bastl-instruments/senseMini/useCases/IMG_7360.JPG

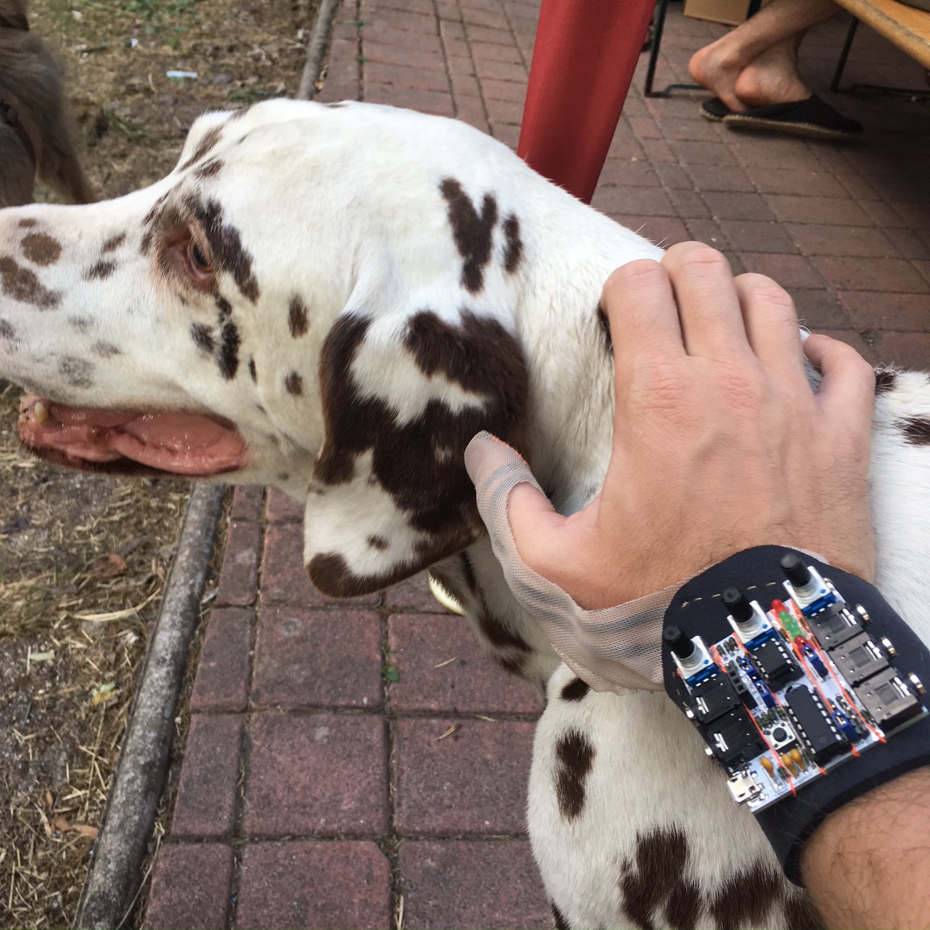
useCases/IMG_7360.JPG
