bastl-instruments/senseMini/useCases/IMG_7311.JPG

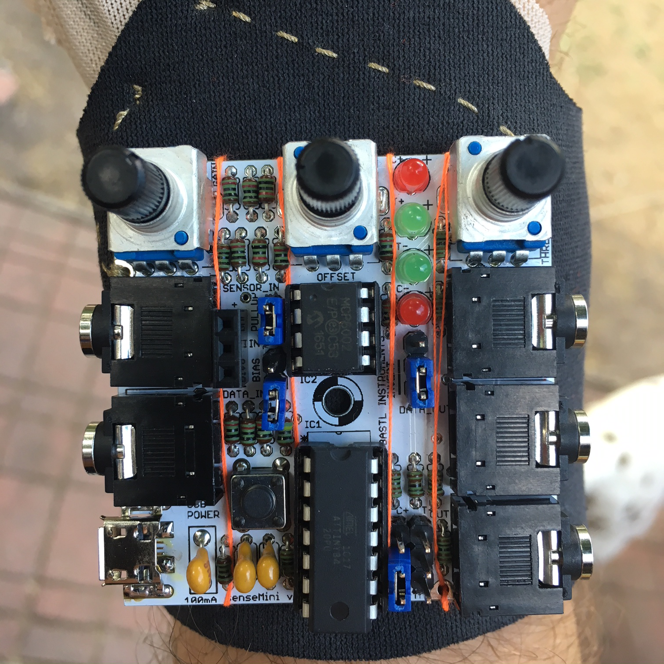
useCases/IMG_7311.JPG
