bastl-instruments/senseMini/manual/senseMini_schematics.png

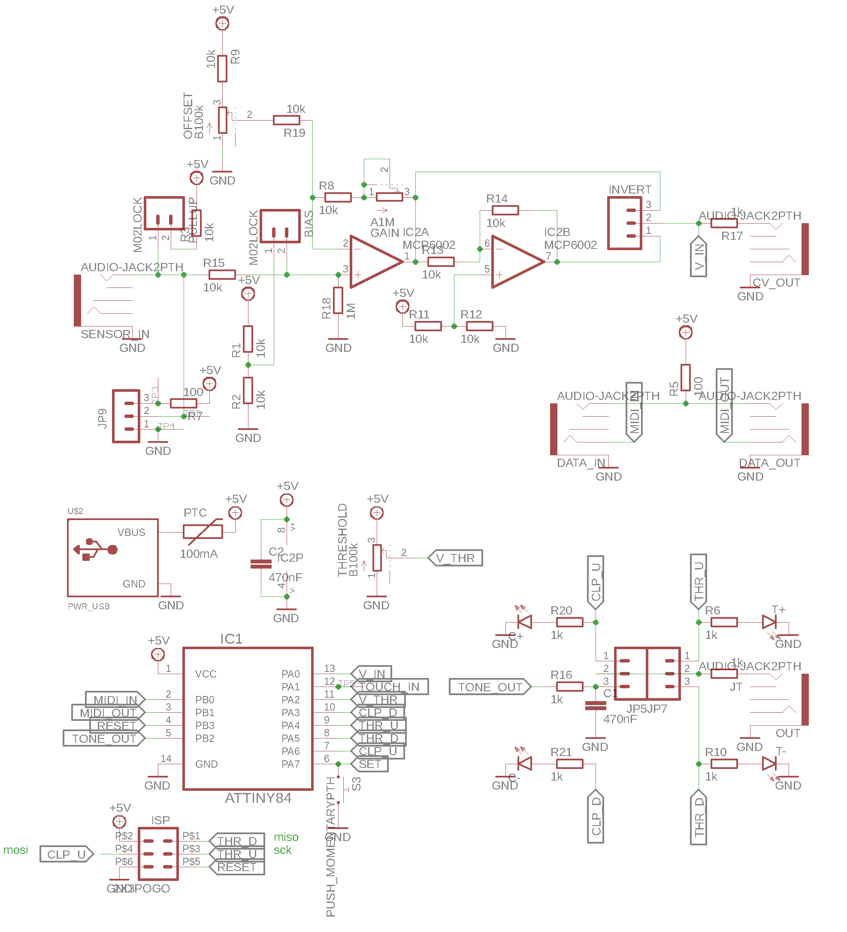
manual/senseMini_schematics.png
