bastl-instruments/senseMini/hw_files/senseMini.dxf

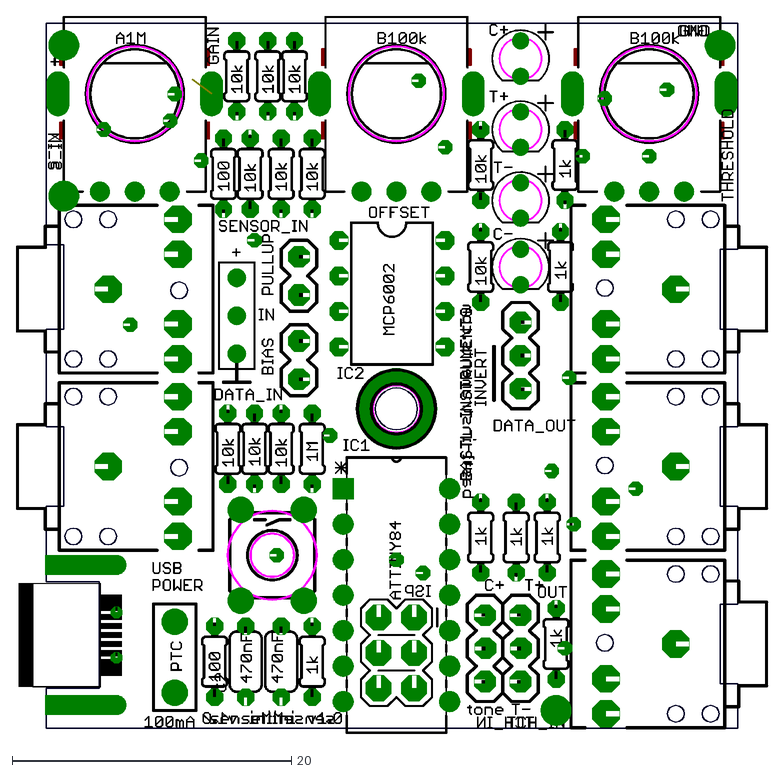
[picture p4: CAD file, 2018-08-09]
hw_files/senseMini.dxf
53.8 x 51.4
