bastl-instruments/senseMini/hw_files/senseMini_future.brd

## EAGLE design hw_files/senseMini_future.brd (2018-08-10)

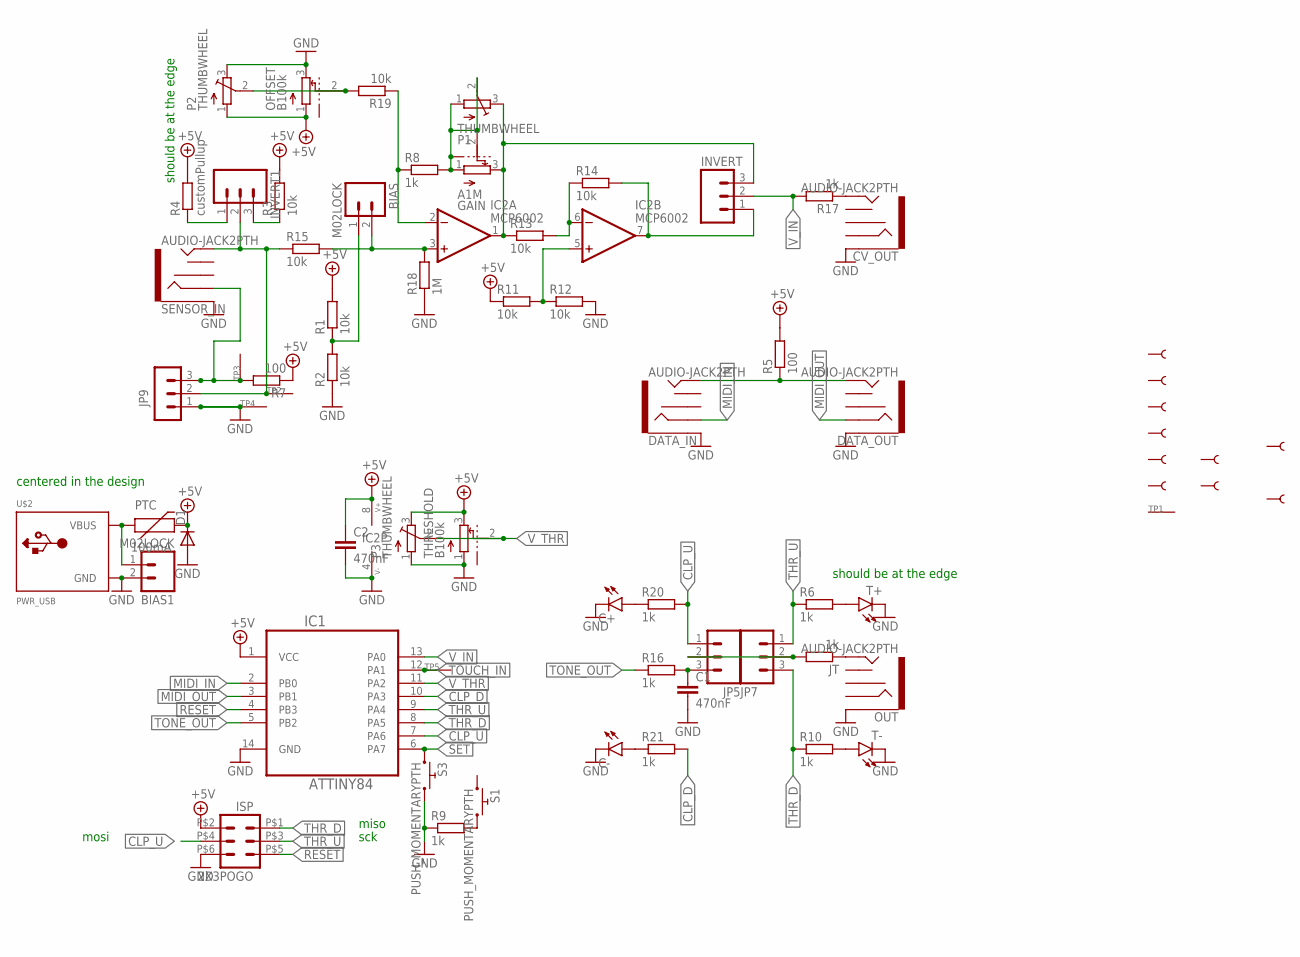
[picture p5: schematic senseMini_future.sch]

Parts:
BIAS, BIAS1: M02LOCK; 1X02_LOCK
C1, C2: 470nF; C_C050-024X044
C+: LED_THT; LEDSMALLHOLES
C-: LED_THT; LEDSMALLHOLES
CV_OUT: AUDIO-JACK2PTH; AUDIO-JACK
D1: DIODE-D-5; D-5
DATA_IN: AUDIO-JACK2PTH; AUDIO-JACK
DATA_OUT: AUDIO-JACK2PTH; AUDIO-JACK
GAIN: A1M; POT_ALPHA
IC1: ATTINY84; DIP254P762X533-14
IC2: MCP6002; DIL08
INVERT, INVERT1: M03LOCK; 1X03_LOCK
ISP: 2X3POGO; 2X3_POGO
JP5, JP7: M03LOCK; 1X03_LOCK
JP9: 1X3_FEMALE; HEADER_1X3_FEMALE
JT: 1k; RCL_0204/5
OFFSET: B100k; POT_ALPHA
OUT: AUDIO-JACK2PTH; AUDIO-JACK
P1, P2, P3: THUMBWHEEL
PTC: 100mA; PTC_THT
R1, R2, R3, R11, R12, R13, R14, R15, R19: 10k; RCL_0204/5
R4: customPullup; RCL_0204/5
R5, R7: 100; RCL_0204/5
R6, R8, R9, R10, R16, R17, R20, R21: 1k; RCL_0204/5
R18: 1M; RCL_0204/5
S1, S3: PUSH_MOMENTARYPTH; TACTILE-PTH
SENSOR_IN: AUDIO-JACK2PTH; AUDIO-JACK
T+: LED_THT; LEDSMALLHOLES
T-: LED_THT; LEDSMALLHOLES
THRESHOLD: B100k; POT_ALPHA
TP1: SEWTAP-2.0IN; SEWINGTAP_2.0
TP2, TP3, TP4, TP5: SEWTAP0.5IN; SEWINGTAP_0.5
U$2: PWR_USB; USBMICRO
U$3, U$4, U$9, U$10, U$11, U$12: SEWTAP2; PETAL-LONG-2
U$5, U$6, U$7, U$8: SEWTAP6; PETAL-SMALL-2SIDE

Connections:
+5V: C2.1, D1.C, IC1.1 (VCC), IC2.8 (V+), ISP.P$2 (2), OFFSET.1, P2.1 (A), P3.3 (E), PTC.P$2 (2), R1.2, R3.2, R4.2, R5.2, R7.1, R11.1, THRESHOLD.3
CLP_D: IC1.10 (PA3), R21.2
CLP_U: IC1.7 (PA6), ISP.P$4 (4), JP5.1, R20.2
GND: BIAS1.2, C1.2, C2.2, C+.K (C), C-.K (C), CV_OUT.SLEEVE, D1.A, DATA_IN.SLEEVE, DATA_OUT.SLEEVE, IC1.14 (GND), IC2.4 (V-), ISP.P$6 (6), JP9.1, OFFSET.3, OUT.SLEEVE, P2.3 (E), P3.1 (A), R2.1, R9.1, R12.2, R18.1, S3.3 (2), S3.4 (2), SENSOR_IN.SLEEVE, T+.K (C), T-.K (C), THRESHOLD.1, TP4.TAP, U$2.GND, U$2.GND1 (GND)
MIDI_IN: DATA_IN.RING, IC1.2 (PB0)
MIDI_OUT: DATA_OUT.RING, IC1.3 (PB1)
unnamed: BIAS1.1, PTC.P$1 (1), U$2.V+ (VBUS), U$2.V+1 (VBUS)
unnamed: INVERT1.1, R4.1
unnamed: BIAS.1, R1.1, R2.2
unnamed: INVERT1.3, R3.1
unnamed: C+.A, R20.1
unnamed: DATA_IN.TIP, DATA_OUT.TIP, R5.1
unnamed: JP9.3, R7.2, SENSOR_IN.RING, TP3.TAP
unnamed: INVERT1.2, JP9.2, R15.1, SENSOR_IN.TIP, TP2.TAP
unnamed: R6.2, T+.A
unnamed: JP5.2, JP7.2, JT.2
unnamed: GAIN.3, IC2.1 (OUT), INVERT.3, P1.3 (E), R13.1
unnamed: C1.1, JP5.3, R16.2
unnamed: R10.2, T-.A
unnamed: GAIN.1, GAIN.2, GAIN.P$1, GAIN.P$2, P1.1 (A), P1.2 (S), R8.2
unnamed: BIAS.2, IC2.3 (+IN), R15.2, R18.2
unnamed: R9.2, S1.3 (2), S1.4 (2)
unnamed: C-.A, R21.1
unnamed: IC2.5 (+IN), R11.2, R12.1
unnamed: IC2.6 (-IN), R13.2, R14.1
unnamed: IC2.7 (OUT), INVERT.1, R14.2
unnamed: JT.1, OUT.TIP
unnamed: CV_OUT.TIP, R17.1
unnamed: IC2.2 (-IN), R8.1, R19.1
unnamed: OFFSET.2, P2.2 (S), R19.2
RESET: IC1.4 (PB3), ISP.P$5 (5)
SET: IC1.6 (PA7), S3.1, S3.2 (1)
THR_D: IC1.8 (PA5), ISP.P$1 (1), JP7.3, R10.1
THR_U: IC1.9 (PA4), ISP.P$3 (3), JP7.1, R6.1
TONE_OUT: IC1.5 (PB2), R16.1
TOUCH_IN: IC1.12 (PA1), TP5.TAP
V_IN: IC1.13 (PA0), INVERT.2, R17.2
V_THR: IC1.11 (PA2), P3.2 (S), THRESHOLD.2

Notes on the sheet:
mosi
miso
sck
should be at the edge
centered in the design

Board: 2 copper layers, 70 parts (1 on the bottom side), 38 nets, no tracks yet.

Other parts of the board:
U$1: 3MM_HOLE
