bastl-instruments/senseMini/manual/senseMini_manual.jpg

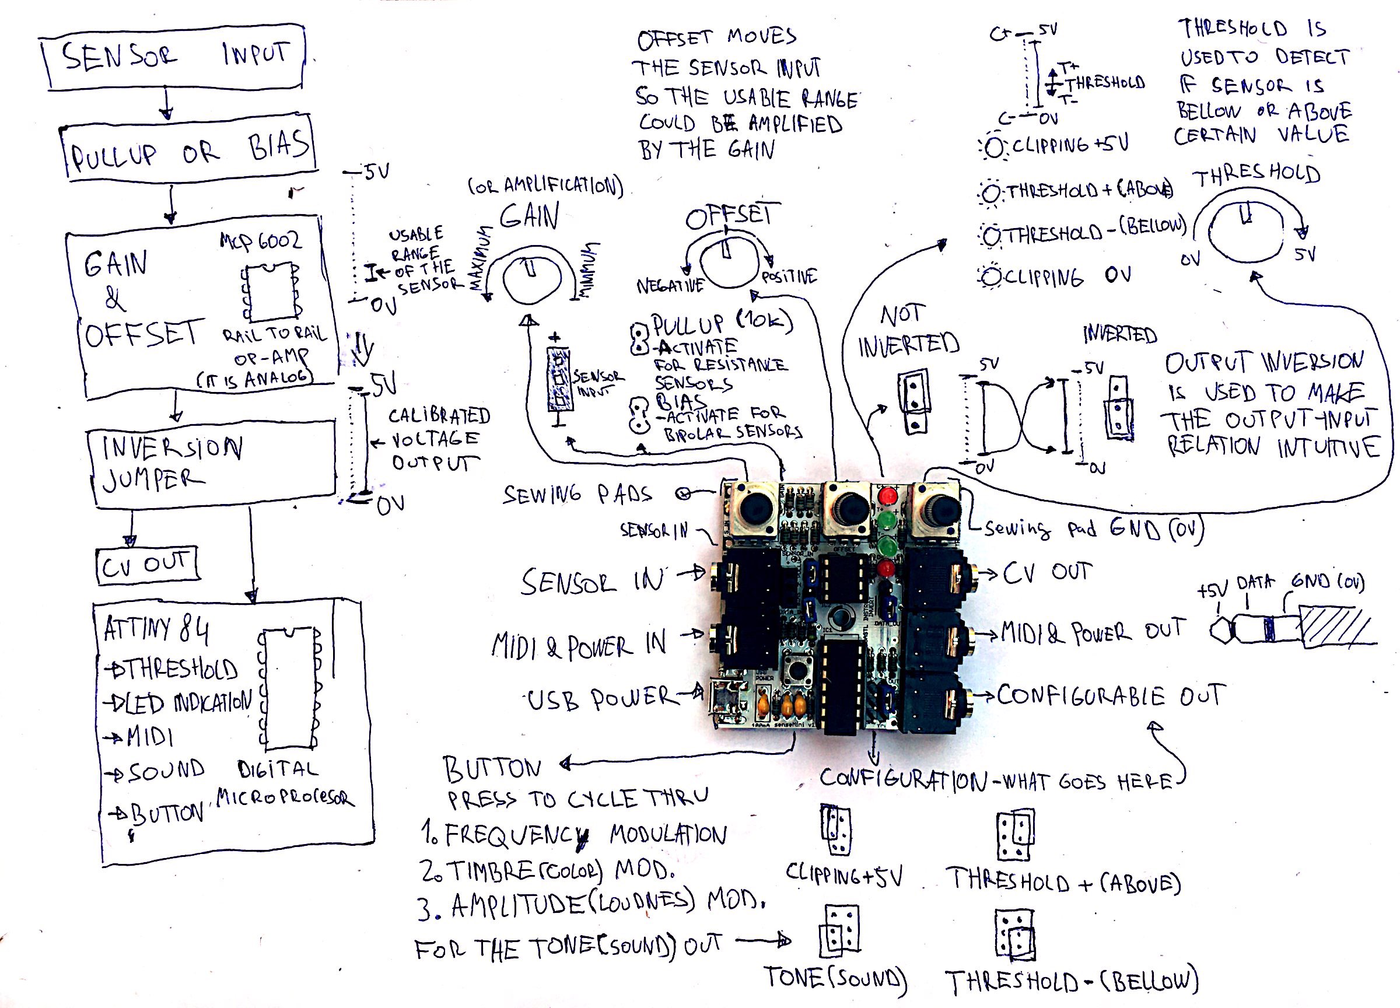
manual/senseMini_manual.jpg
