bastl-instruments/senseMini/manual/howToCalibrate-01.jpg

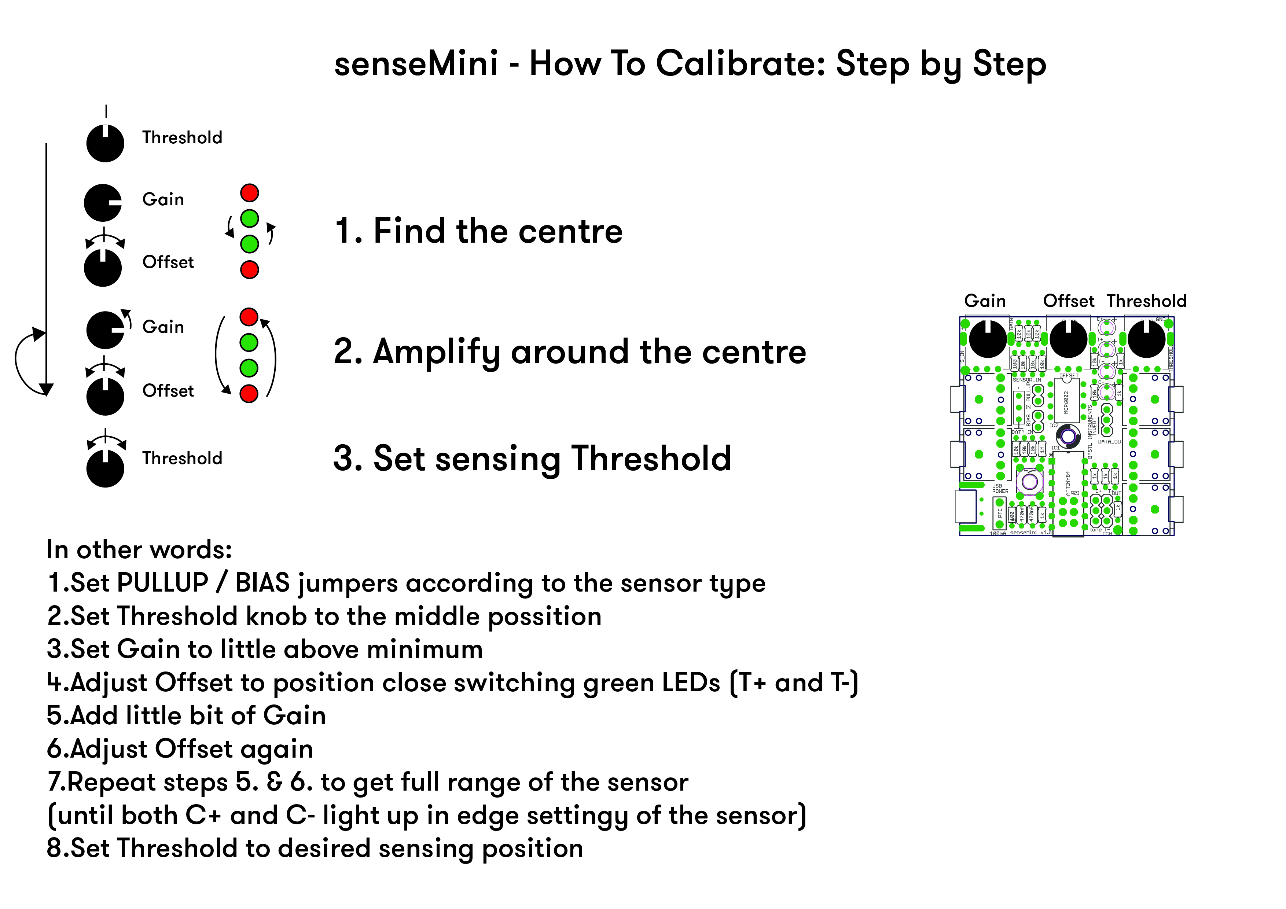
manual/howToCalibrate-01.jpg
