bastl-instruments/senseMini/(commit log)

2018-08-09 initial commit - schematics & code & manual
2018-08-09 added manual + hw files + use cases
    [senseMini.brd, senseMini.dxf, senseMini.sch]
2018-08-10 ADDED SKETCH FOR FUTURE DESIGN
    [senseMini_future.brd, senseMini_future.sch]
